Lanove/Stromvy/hardwares/scha3.pdf

# J2 C16 C15

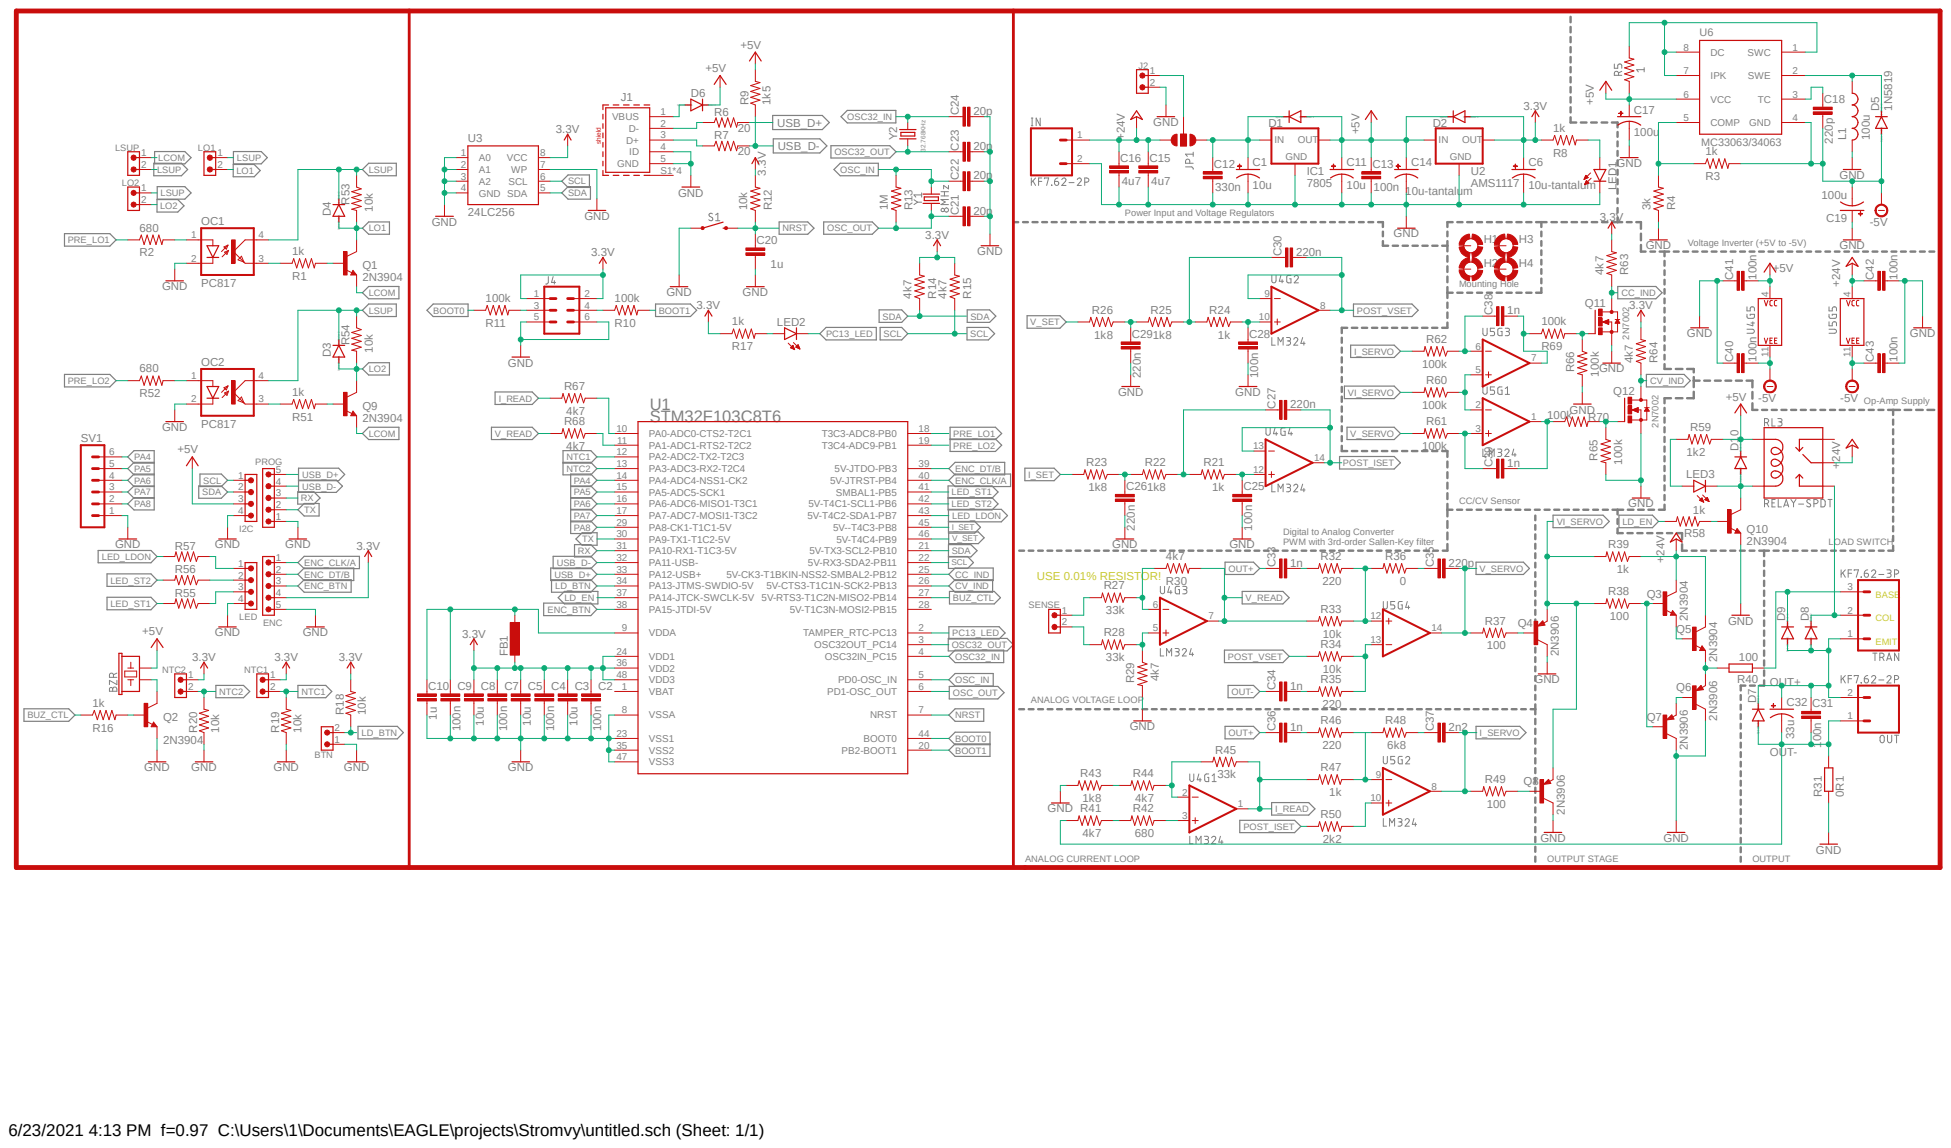
[picture p1: page 1]

Power Input and Voltage Regulators

6/23/2021 4:13 PM f=0.97 C:\Users\1\Documents\EAGLE\projects\Stromvy\untitled.sch (Sheet: 1/1)
