Lanove/Stromvy/hardwares/scha4.pdf

# 20p 4k7 4k7

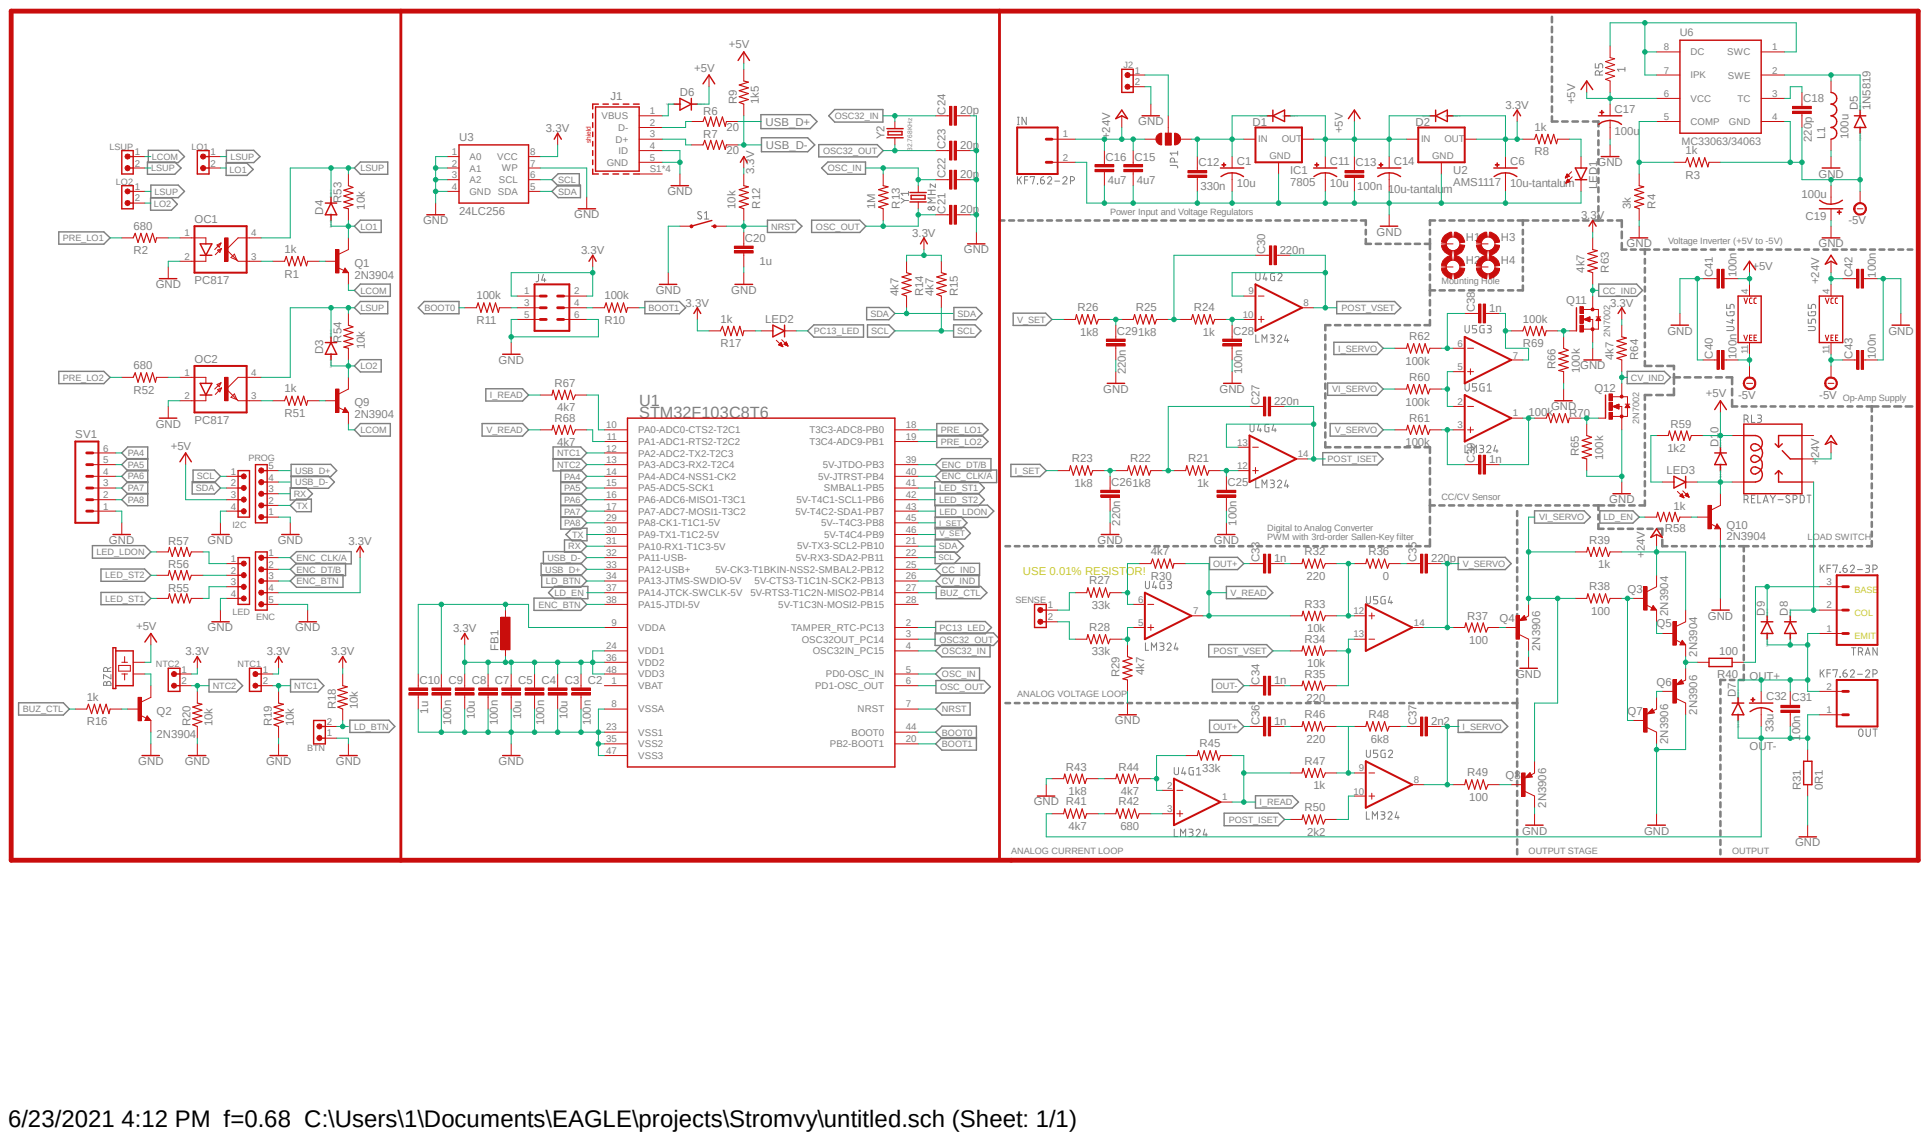
[picture p2: page 1]

Power Input and Voltage Regulators

Digital to Analog Converter
PWM with 3rd-order Sallen-Key filter

VSS3 47 | BOOT1

6/23/2021 4:12 PM f=0.68 C:\Users\1\Documents\EAGLE\projects\Stromvy\untitled.sch (Sheet: 1/1)
