Lanove/Stromvy/hardwares/CAMOutputs/sch.pdf

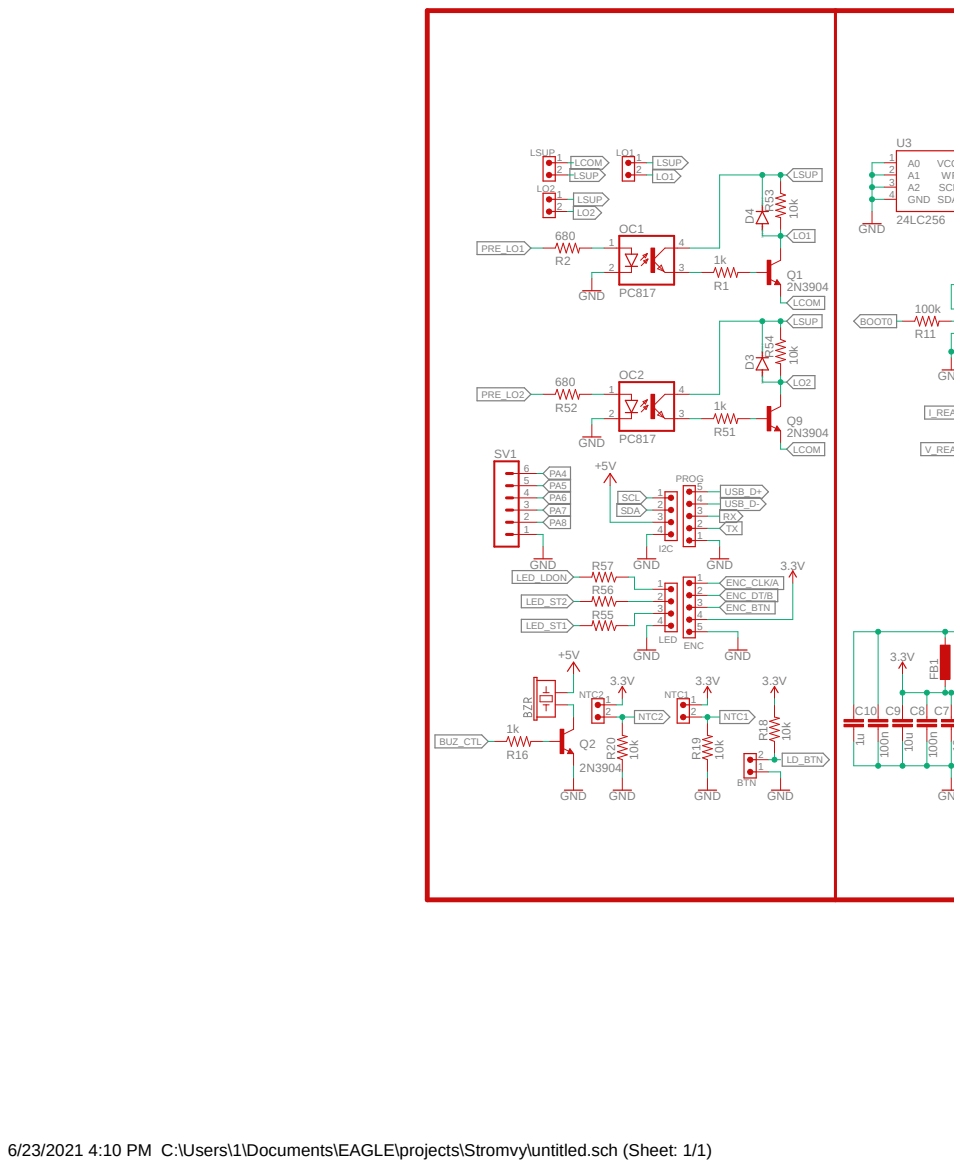
[picture p3: page 1]

20p 4k7 | 4k7
J2 C16 | C15

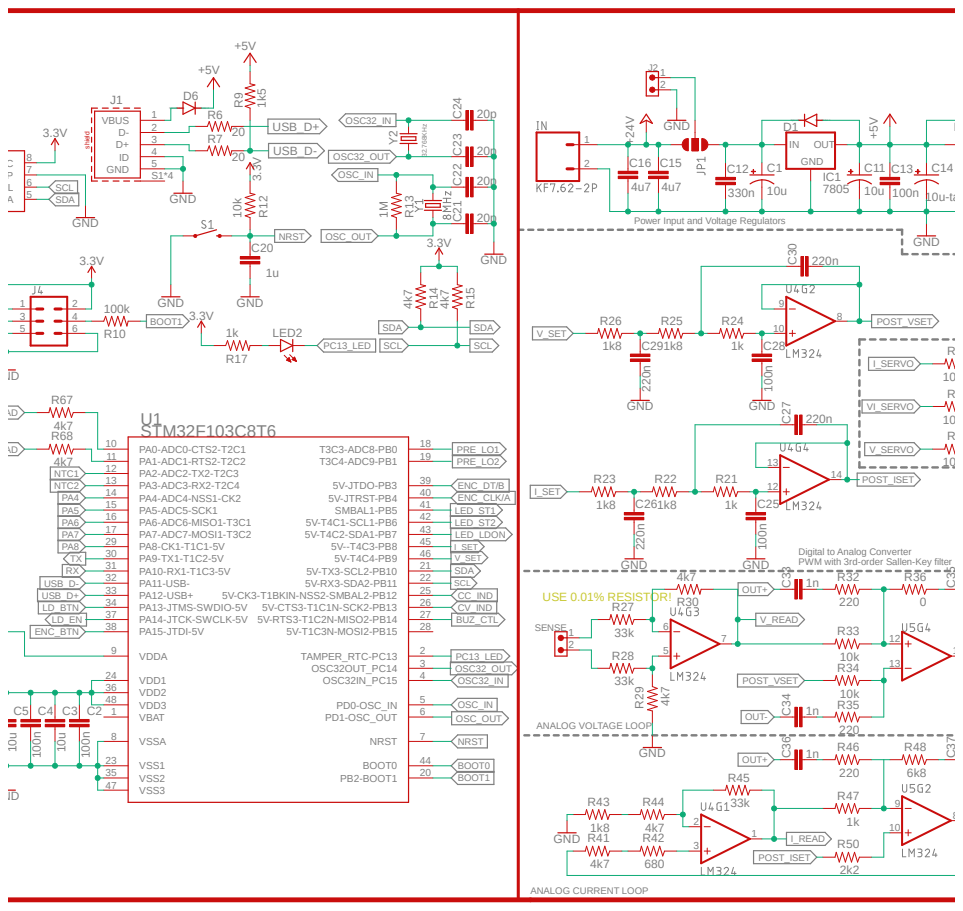
[picture p4: page 2]

Power Input and Voltage Regulators

Digital to Analog Converter
PWM with 3rd-order Sallen-Key filter

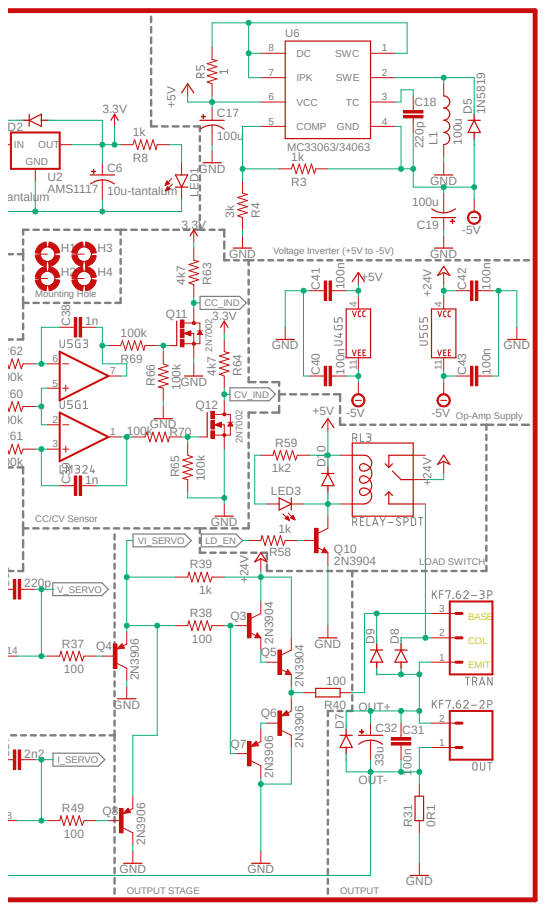
[picture p5: page 3]
