Lanove/Stromvy/hardwares/LTSPICE SIM.asc

C1: cap; 220n
C2: cap; 220n
C3: cap; 100n
C4: cap; 220n
C5: cap; 100n
C6: cap; 220n
C7: cap; 1n
C8: cap; 1n
C9: cap; 220p
C10: cap; 1n
C11: cap; 2.2n
C12: cap; 0.1µ; V=100 Irms=1.4 Rser=0.0913262 Lser=0 mfg="KEMET" pn="C0805C104K1RAC" type="X7R"
C13: polcap; 33µ; V=100 Irms=160m Rser=0.46 Lser=0 mfg="Nichicon" pn="UPR2A330MPH" type="Al electrolytic"
Q2: npn; 2N2222
Q3: npn; 2N2222
Q4: pnp; 2N2907
Q5: pnp; 2N2907
Q6: npn; 2N3055
Q7: pnp; 2N2907
Q8: pnp; 2N2907
R1: res; 1k8
R2: res; 1k
R3: res; 1k8
R4: res; 1k8
R5: res; 1k
R6: res; 1k8
R7: res; 1
R8: res; 0.1
R9: res; 33k; tol=1
R10: res; 33k; tol=1
R11: res; 4k7; tol=1
R12: res; 4k7; tol=1
R13: res; 10k
R14: res; 220
R15: res; 10k
R16: res; 220
R17: res; 680
R18: res; 33k
R19: res; 4k7
R20: res; 1k8
R21: res; 4k7
R22: res; 1k
R23: res; 220
R24: res; 2k2
R25: res; 100
R26: res; 100
R27: res; 6k8
R28: res; 10
R29: res; 100
R30: res; 1k
SW: sw
U1: LM324
U2: LM324
U3: TL084
U4: TL084
U5: TL084
U6: TL084
V1: voltage; 5
V2: voltage; 5
V3: voltage; 24; Rser=1m
V4: voltage; PULSE(0 3.0 0 1n 1n 33.3u 66.6u)
V5: voltage; PULSE(0 2.8 0 1n 1n 33.3u 66.6u)
V6: voltage; PULSE(0 5 6m 1n 1n 1s 1s)
Named nets: 0, VA+, VA-, +24V, I_SET, V_SET, SKI, SKV, OUT+, OUT-, TR_DRIVE, U6_OUT, U4_OUT
.tran 0 10m 0m 1m uic
360uVp-p noise output 3.3V/3ms
0-2.8V -> 0-20V
0-3V -> 0-5A
.model SW SW(Ron=0.01 Roff=1000Meg Vt=.5 Vh=-.4)
.options gmin=1e-10
.options abstol=1e-10
.options reltol=0.003
.options cshunt=1e-15
