Lanove/Stromvy/hardwares/untitled.brd

## EAGLE design hardwares/untitled.brd (2021-08-20)

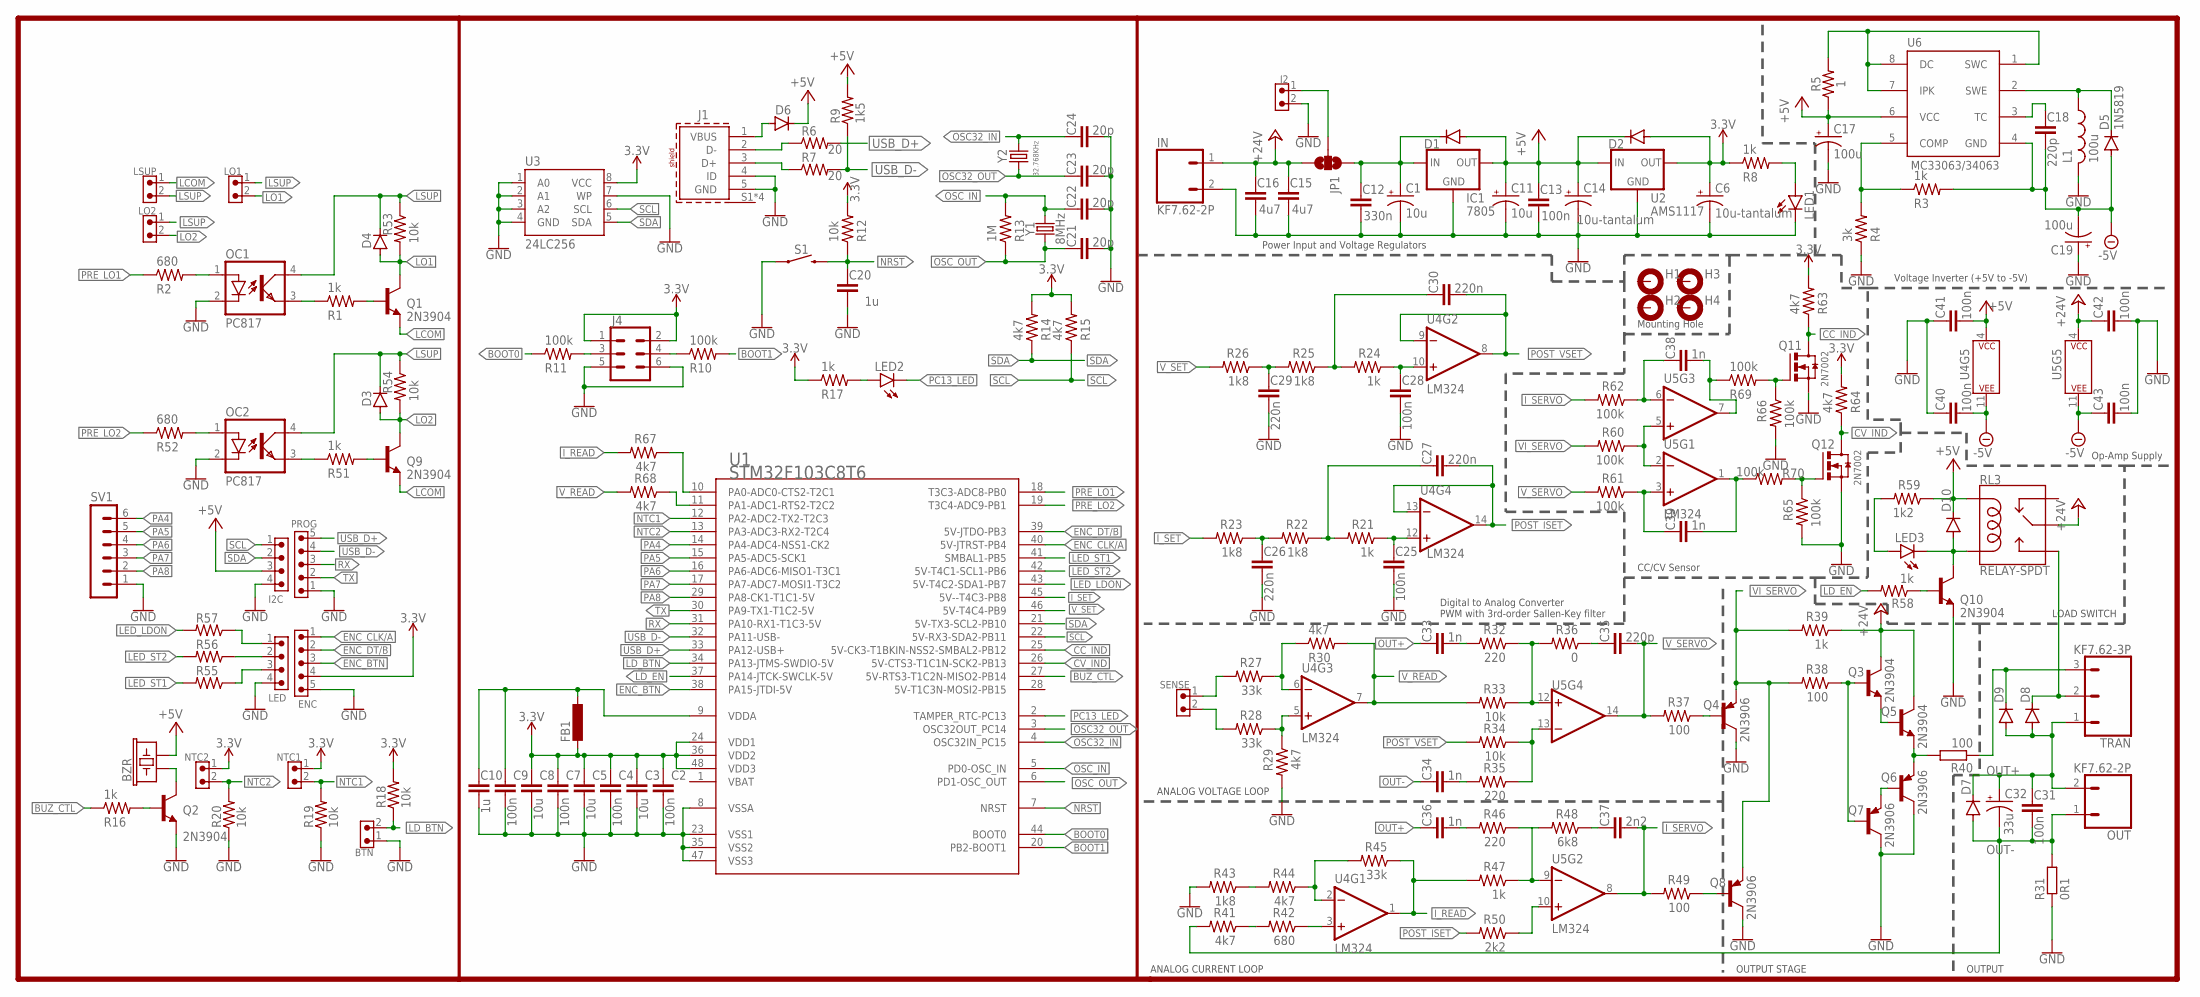
[picture p6: schematic untitled.sch]

Parts:
BTN: 61900211121
BZR: BUZZER-PTH_KIT; BUZZER-12MM-KIT
C1, C11: 10u; E2,5-6
C2, C4, C7, C9, C13, C25, C28, C31, C40, C41, C42, C43: 100n; C0805
C3, C5, C8: 10u; C0805
C6, C14: 10u-tantalum; CT3528
C10, C20: 1u; C0805
C12: 330n; C0805
C15, C16: 4u7; C0805
C17, C19: 100u; E2,5-6
C18, C35: 220p; C0805
C21, C22, C23, C24: 20p; C0805
C26, C27, C29, C30: 220n; C0805
C32: 33u; D/7343-31R
C33, C34, C36, C38, C39: 1n; C0805
C37: 2n2; C0805
D1, D2, D3, D4, D6, D7, D8, D9, D10: DIODE-DO-214AC; DO-214AC
D5: 1N5819; DO-214AC
ENC: 61900511121
FB1: L-EUL1812; L1812
H1, H2, H3, H4: MOUNT-PAD-ROUND3.2; 3,2-PAD
I2C: 61900411121
IC1: 7805; 78XXS
IN: KF7.62-2P; KF7.62
J1: 629105136821
J2: 61900211121
J4: FEMALE 2x3; 2X3
JP1: JUMPER-SMT_3_NO_NO-SILK; SMT-JUMPER_3_NO_NO-SILK
L1: 100u; 6000-XXXX-RC
LED: 61900411121
LED1, LED2, LED3: LEDCHIP-LED0805; CHIP-LED0805
LO1, LO2: 61900211121
LSUP: 61900211121
NTC1, NTC2: 61900211121
OC1, OC2: PC817; DIL04
OUT: KF7.62-2P; KF7.62
PROG: 61900511121
Q1, Q2, Q3, Q5, Q9, Q10: 2N3904; TO92
Q4, Q6, Q7, Q8: 2N3906; TO92
Q11, Q12: 2N7002; SOT23-3
R1, R3, R8, R16, R17, R21, R24, R39, R47, R51, R58: 1k; M0805
R2, R42, R52, R55, R56, R57: 680; M0805
R4: 3k; M0805
R5: 1; 2010
R6, R7: 20; M0805
R9: 1k5; M0805
R10, R11, R60, R61, R62, R65, R66, R69, R70: 100k; M0805
R12, R18, R19, R20, R33, R34, R53, R54: 10k; M0805
R13: 1M; M0805
R14, R15, R29, R30, R41, R44, R63, R64, R67, R68: 4k7; M0805
R22, R23, R25, R26, R43: 1k8; M0805
R27, R28, R45: 33k; M0805
R31: 0R1; 0922/22
R32, R35, R46: 220; M0805
R36: 0; M0805
R37, R38, R49: 100; M0805
R40: 100; 0922/22
R48: 6k8; M0805
R50: 2k2; M0805
R59: 1k2; M0805
RL3: RELAY-SPDT; RELAY_G5LE
S1: MOMENTARY-SWITCH-SPST-SMD-6.2MM-TALL; TACTILE_SWITCH_SMD_6.2MM_TALL
SENSE: 61900211121
SV1: MA06-1
TRAN: KF7.62-3P
U1: STM32F103C8T6; TQFP48
U2: AMS1117; SOT89R
U3: 24LC256; SO08
U4, U5: LM324; SO14
U6: 34063; SO08
Y1: 8MHz; HC49US
Y2: 32.768KHz; MC-306

Connections:
3.3V: C2.1, C3.1, C4.1, C5.1, C6.+, C7.1, C8.1, D2.A, ENC.4, FB1.2, J4.1, J4.2, NTC1.1, NTC2.1, R8.1, R12.2, R14.2, R15.2, R17.1, R18.2, R63.2, R64.2, U1.24 (VDD1), U1.36 (VDD2), U1.48 (VDD3), U2.3 (OUT), U2.4 (OUT), U3.8 (VCC)
+5V: BZR.- (2), C11.+, C13.1, C14.+, C17.+, C41.2, D1.A, D2.C, D6.C, D10.C, I2C.3, IC1.OUT, R5.1, R9.2, R59.1, RL3.2 (COIL1), U2.1 (IN), U4.4 (P$V+), U6.6 (VCC)
+24V: C15.1, C16.1, C42.1, IN.1, JP1.3, Q3.1 (C), Q5.1 (C), R39.1, RL3.1 (MAIN), U5.4 (P$V+)
-5V: C18.2, C19.-, C40.2, C43.1, D5.A, R3.2, U4.11 (P$V-), U5.11 (P$V-), U6.4 (GND)
BASE: D9.C, R40.1, TRAN.3
BOOT0: R11.1, U1.44 (BOOT0)
BOOT1: R10.2, U1.20 (PB2-BOOT1)
BUZ_CTL: R16.1, U1.27 (5V-RTS3-T1C2N-MISO2-PB14)
CC_IND: Q11.3 (D), R63.1, U1.25 (5V-CK3-T1BKIN-NSS2-SMBAL2-PB12)
COL: D8.C, RL3.3 (NO), TRAN.2
CV_IND: Q12.3 (D), R64.1, U1.26 (5V-CTS3-T1C1N-SCK2-PB13)
ENC_BTN: ENC.3, U1.38 (PA15-JTDI-5V)
ENC_CLK/A: ENC.1, U1.40 (5V-JTRST-PB4)
ENC_DT/B: ENC.2, U1.39 (5V-JTDO-PB3)
GND: BTN.1, C1.-, C2.2, C3.2, C4.2, C5.2, C6.-, C7.2, C8.2, C9.2, C10.2, C11.-, C12.2, C13.2, C14.-, C15.2, C16.2, C17.-, C19.+, C20.2, C21.2, C22.2, C23.2, C24.2, C25.2, C26.2, C28.2, C29.2, C40.1, C41.1, C42.2, C43.2, ENC.5, I2C.4, IC1.GND, IN.2, J1.4 (ID), J1.5 (GND), J2.2, J4.5, J4.6, L1.2, LED.4, LED1.C, OC1.2 (C), OC2.2 (C), PROG.1, Q2.3 (E), Q4.1 (C), Q6.1 (C), Q7.1 (C), Q8.1 (C), Q10.3 (E), Q11.2 (S), Q12.2 (S), R4.1, R19.1, R20.1, R29.2, R31.1, R43.2, R65.2, R66.2, S1.A2 (1), SV1.1, U1.8 (VSSA), U1.23 (VSS1), U1.35 (VSS2), U1.47 (VSS3), U2.2 (GND), U3.1 (A0), U3.2 (A1), U3.3 (A2), U3.4 (GND), U3.7 (WP)
I_READ: R45.1, R47.2, R67.2, U4.1 (OUT)
I_SERVO: C37.2, R49.2, R62.2, U5.8 (OUT)
I_SET: R23.2, U1.45 (5V--T4C3-PB8)
LCOM: LSUP.1, Q1.3 (E), Q9.3 (E)
LD_BTN: BTN.2, R18.1, U1.34 (PA13-JTMS-SWDIO-5V)
LD_EN: R58.2, U1.37 (PA14-JTCK-SWCLK-5V)
LED_LDON: R57.2, U1.43 (5V-T4C2-SDA1-PB7)
LED_ST1: R55.2, U1.41 (SMBAL1-PB5)
LED_ST2: R56.2, U1.42 (5V-T4C1-SCL1-PB6)
LO1: D4.A, LO1.2, Q1.1 (C), R53.2
LO2: D3.A, LO2.2, Q9.1 (C), R54.2
LSUP: D3.C, D4.C, LO1.1, LO2.1, LSUP.2, OC1.4 (COL), OC2.4 (COL), R53.1, R54.1
unnamed: C1.+, C12.1, D1.C, IC1.IN, JP1.1
unnamed: Q1.2 (B), R1.2
unnamed: J2.1, JP1.2
unnamed: LED1.A, R8.2
unnamed: OC1.3 (EMIT), R1.1
unnamed: D6.A, J1.1 (VBUS)
unnamed: Q9.2 (B), R51.2
unnamed: OC2.3 (EMIT), R51.1
unnamed: OC2.1 (A), R52.2
unnamed: OC1.1 (A), R2.2
unnamed: C9.1, C10.1, FB1.1, U1.9 (VDDA)
unnamed: C18.1, U6.3 (TC)
unnamed: D5.C, L1.1, U6.2 (SWE)
unnamed: R5.2, U6.1 (SWC), U6.7 (IPK), U6.8 (DC)
unnamed: J1.3 (D+), R7.1
unnamed: R3.1, R4.2, U6.5 (COMP)
unnamed: J1.2 (D-), R6.1
unnamed: J4.3, R11.2
unnamed: J4.4, R10.1
unnamed: Q2.2 (B), R16.2
unnamed: LED2.A, R17.2
unnamed: BZR.+ (1), Q2.1 (C)
unnamed: C28.1, R24.1, U4.10 (+IN)
unnamed: C29.1, R25.2, R26.1
unnamed: C30.1, R24.2, R25.1
unnamed: Q3.2 (B), Q7.2 (B), R38.1
unnamed: R27.1, R30.1, U4.6 (-IN)
unnamed: R28.1, R29.1, U4.5 (+IN)
unnamed: C25.1, R21.1, U4.12 (+IN)
unnamed: C27.1, R21.2, R22.1
unnamed: C26.1, R22.2, R23.1
unnamed: Q6.2 (B), Q7.3 (E)
unnamed: R68.1, U1.11 (PA1-ADC1-RTS2-T2C2)
unnamed: R32.1, R33.1, R36.2, U5.12 (+IN)
unnamed: LED.1, R57.1
unnamed: C33.2, R32.2
unnamed: Q5.3 (E), Q6.3 (E), R40.2
unnamed: Q3.3 (E), Q5.2 (B)
unnamed: C35.1, R36.1
unnamed: R67.1, U1.10 (PA0-ADC0-CTS2-T2C1)
unnamed: C34.2, R35.2
unnamed: R34.1, R35.1, U5.13 (-IN)
unnamed: Q4.2 (B), R37.1
unnamed: Q12.1 (G), R65.1, R70.2
unnamed: R41.1, R42.2
unnamed: R42.1, U4.3 (+IN)
unnamed: R44.1, R45.2, U4.2 (-IN)
unnamed: R43.1, R44.2
unnamed: Q11.1 (G), R66.1, R69.2
unnamed: C38.2, R69.1, U5.7 (OUT)
unnamed: C36.2, R46.2
unnamed: R46.1, R47.1, R48.2, U5.9 (-IN)
unnamed: C37.1, R48.1
unnamed: R50.1, U5.10 (+IN)
unnamed: Q8.2 (B), R49.1
unnamed: LED.2, R56.1
unnamed: LED.3, R55.1
unnamed: D10.A, LED3.C, Q10.1 (C), RL3.5 (COIL2)
unnamed: R60.1, U5.2 (-IN), U5.5 (+IN)
unnamed: Q10.2 (B), R58.1
unnamed: LED3.A, R59.2
unnamed: C39.1, R61.1, U5.3 (+IN)
unnamed: C39.2, R70.1, U5.1 (OUT)
unnamed: C38.1, R62.1, U5.6 (-IN)
NRST: C20.1, R12.1, S1.B2 (2), U1.7 (NRST)
NTC1: NTC1.2, R19.2, U1.12 (PA2-ADC2-TX2-T2C3)
NTC2: NTC2.2, R20.2, U1.13 (PA3-ADC3-RX2-T2C4)
OSC32_IN: C24.1, U1.4 (OSC32IN_PC15), Y2.4 (2)
OSC32_OUT: C23.1, U1.3 (OSC32OUT_PC14), Y2.1
OSC_IN: C22.1, R13.2, U1.5 (PD0-OSC_IN), Y1.2
OSC_OUT: C21.1, R13.1, U1.6 (PD1-OSC_OUT), Y1.1
OUT+: C31.1, C32.+, C33.1, C36.1, D7.C, D8.A, D9.A, OUT.2, TRAN.1
OUT-: C31.2, C32.-, C34.1, D7.A, OUT.1, R31.2, R41.2
PA4: SV1.6, U1.14 (PA4-ADC4-NSS1-CK2)
PA5: SV1.5, U1.15 (PA5-ADC5-SCK1)
PA6: SV1.4, U1.16 (PA6-ADC6-MISO1-T3C1)
PA7: SV1.3, U1.17 (PA7-ADC7-MOSI1-T3C2)
PA8: SV1.2, U1.29 (PA8-CK1-T1C1-5V)
PC13_LED: LED2.C, U1.2 (TAMPER_RTC-PC13)
POST_ISET: C27.2, R50.2, U4.13 (-IN), U4.14 (OUT)
POST_VSET: C30.2, R34.2, U4.8 (OUT), U4.9 (-IN)
PRE_LO1: R2.1, U1.18 (T3C3-ADC8-PB0)
PRE_LO2: R52.1, U1.19 (T3C4-ADC9-PB1)
RX: PROG.3, U1.31 (PA10-RX1-T1C3-5V)
SCL: I2C.1, R15.1, U1.22 (5V-RX3-SDA2-PB11), U3.6 (SCL)
SDA: I2C.2, R14.1, U1.21 (5V-TX3-SCL2-PB10), U3.5 (SDA)
SENSE+: R28.2, SENSE.2
SENSE-: R27.2, SENSE.1
TX: PROG.2, U1.30 (PA9-TX1-T1C2-5V)
USB_D+: PROG.5, R6.2, U1.33 (PA12-USB+)
USB_D-: PROG.4, R7.2, R9.1, U1.32 (PA11-USB-)
VBAT: U1.1 (VBAT)
VI_SERVO: Q4.3 (E), Q8.3 (E), R38.2, R39.2, R60.2
V_READ: R30.2, R33.2, R68.2, U4.7 (OUT)
V_SERVO: C35.2, R37.2, R61.2, U5.14 (OUT)
V_SET: R26.2, U1.46 (5V-T4C4-PB9)

Notes on the sheet:
Digital to Analog Converter PWM with 3rd-order Sallen-Key filter
CC/CV Sensor
Mounting Hole
Op-Amp Supply
Voltage Inverter (+5V to -5V)
Power Input and Voltage Regulators
ANALOG VOLTAGE LOOP
ANALOG CURRENT LOOP
OUTPUT STAGE
LOAD SWITCH
OUTPUT

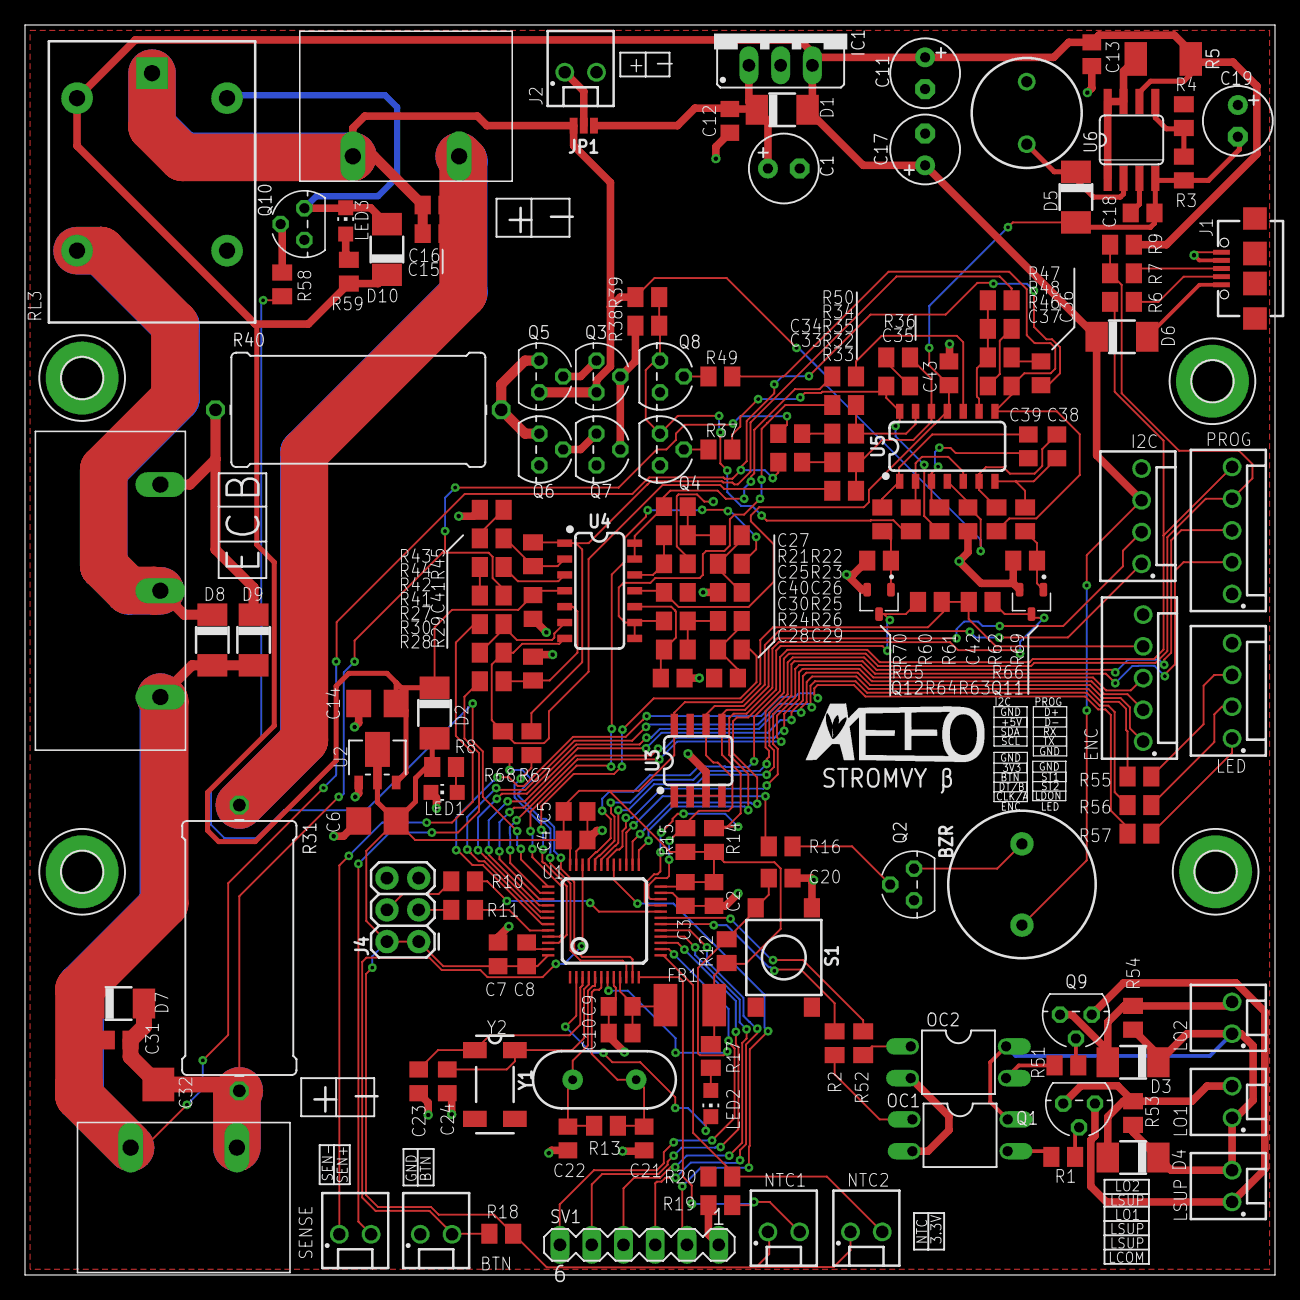
[picture p7: board untitled.brd from above]

Board: 2 copper layers, 100.0 x 100.0 mm, 177 parts (0 on the bottom side), 122 nets.
