Lanove/Stromvy/(commit log)

2021-08-06 added HAL GPIO and ADC Init, and HAL adcRead
2021-08-06 change V and I ADC to external ADS1115, added RunningAverage
2021-08-11 added lcdController and encoderController
    [LCD User Interface.xlsx]
2021-08-14 Added setScreen() functionality (WIP)
    [LCD User Interface.xlsx]
2021-08-15 lcdController done (untested) added encoderController
    [LCD User Interface.xlsx]
2021-08-15 lcdController and encoderController work Added navigations
    [LCD User Interface.xlsx]
2021-08-19 fixed encoder acceleration problem by adding 1ms interrupt
    [encoderController.cpp, encoderController.h, main.cpp]
2021-08-19 Added eepromControllerClass bugfix sensed voltage on cal screen not updating
    [eepromController.cpp, eepromController.h, encoderController.cpp, globals.h, lcdController.cpp, main.cpp]
2021-08-19 minor bugfix : presetCurrent does'nt update EEPROM changed EEPROM update method to every double click
    [eepromController.cpp, encoderController.cpp]
2021-08-19 added load button functionality DAC /dec 7.7kHz when ldStatus first on
2021-08-19 added overheat handler added fan handler added power sensing tested 50W transistor dissipation
    [globals.h, main.cpp]
2021-08-19 added energy info functionality and minor bugfix for lcd
    [lcdController.cpp, main.cpp]
2021-08-19 added timer and logging functionality
2021-08-20 Added hardware files
    [copper_bottom.gbr, copper_top.gbr, drills.xln, gerber_job.gbrjob, profile.gbr, silkscreen_bottom.gbr, silkscreen_top.gbr, soldermask_bottom.gbr]
2021-08-23 Modified encoder acceleration timer to better move on slower speed. Modified CC/CV Buzzer to not overlap. Fixed actual power lcd to not display negative value Changed current ADC offset to 80. Added 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
    [globals.h, indicatorController.cpp, lcdController.cpp, main.cpp]
2021-08-28 Added watchdog capability with 4 second timeout Use original and newest ver of running average lib (v0.4.0) Fixed sensedPower on LCD to not display negative sign
    [globals.h, lcdController.cpp, main.cpp]
2021-08-29 Added modification list Added deconstructor for each controllerClass RunningAverage now average real voltage (float) instead of the ADC value (int16_t) Added memory debug function (unused)
2021-09-02 Added i2c refresh routine (every 5 min or ldButton dbclick)
2021-09-04 Changed watchdog time out to 6s Changed i2c refresh interval to 30m I2C refresh now reset watchdog timer aswell Added ADC reading timeout counter and measure Added LCD debug screen
    [LCD User Interface.xlsx]
2021-09-04 Use object instead of pointer to class for lcd,encoder,eeprom,timer, and running average fix running average maximum size to 20 (no malloc)
    [eepromController.cpp, eepromController.h, encoderController.cpp, encoderController.h, globals.h, indicatorController.cpp, indicatorController.h, lcdController.cpp]
