Lanove/Stromvy/(notices)

Notices in the files:
parts and their libraries:
Wurth_Connectors_WR-WTB: Copyright: Würth Elektronik
SparkFun-Electromechanical: Licensing: Creative Commons ShareAlike 4.0 International - https://creativecommons.org/licenses/by-sa/4.0
